ChrisAnnTerra/Solar-USB-Charger/README.md

## DIY Solar Battery Charger

Power Electronics Class project for ENGR 460. This project was intended for personal use of hobbyist level electronics. 

### Please Refer to the Wiki for further documentation, circuit description, testing notes, and state of the project.
