ChrisAnnTerra/Solar-USB-Charger/JessopIII_SPP460/JessopIII_SPP460.kicad_pcb

## KiCad design JessopIII_SPP460/JessopIII_SPP460.kicad_pcb (2020-06-02)

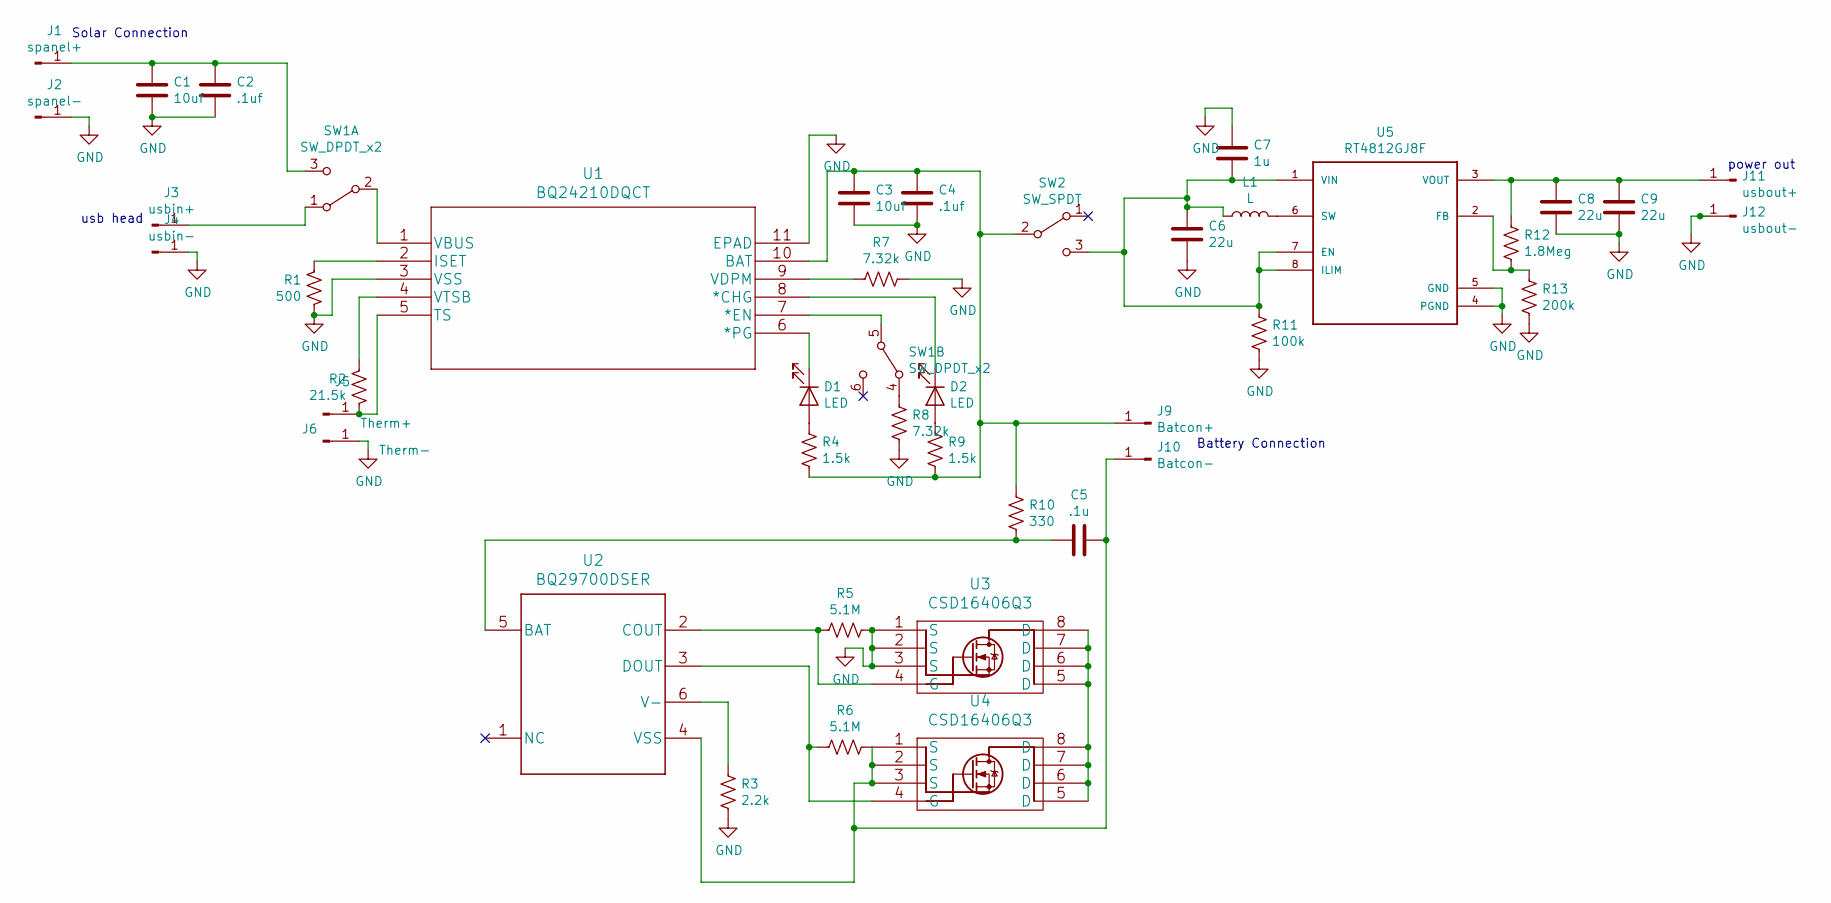
[picture p1: schematic JessopIII_SPP460.sch, Solar powered battery]

Parts:
C1, C3: 10uf; C_0805_2012Metric
C2, C4: .1uf; C_0805_2012Metric
C5: .1u; C_0805_2012Metric
C6, C8, C9: 22u; C_0805_2012Metric
C7: 1u; C_0805_2012Metric
D1, D2: LED; LED_0805_2012Metric
J1: spanel+; SolderWirePad_1x01_Drill1mm
J2: spanel-; SolderWirePad_1x01_Drill1mm
J3: usbin+; SolderWirePad_1x01_Drill1mm
J4: usbin-; SolderWirePad_1x01_Drill1mm
J5: Therm+; SolderWirePad_1x01_Drill1mm
J6: Therm-; SolderWirePad_1x01_Drill1mm
J9: Batcon+; SolderWirePad_1x01_Drill1.5mm
J10: Batcon-; SolderWirePad_1x01_Drill1.5mm
J11: usbout+; SolderWirePad_1x01_Drill1mm
J12: usbout-; SolderWirePad_1x01_Drill1mm
L1: L; L_Bourns-SRN6028
R1: 500; R_0805_2012Metric
R2: 21.5k; R_0805_2012Metric
R3: 2.2k; R_0805_2012Metric
R4, R9: 1.5k; R_0805_2012Metric
R5, R6: 5.1M; R_0805_2012Metric
R7, R8: 7.32k; R_0805_2012Metric
R10: 330; R_0805_2012Metric
R11: 100k; R_0805_2012Metric
R12: 1.8Meg; R_0805_2012Metric
R13: 200k; R_0805_2012Metric
SW1: SW_DPDT_x2; SW_CuK_JS202011CQN_DPDT_Straight
SW2: SW_SPDT; PinSocket_1x03_P2.54mm_Vertical
U1: BQ24210DQCT
U2: BQ29700DSER
U3, U4: CSD16406Q3; TRANS_CSD17575Q3
U5: RT4812GJ8F; SOT65P279X100-8N

Connections:
GND: C1.2, C2.2, C3.2, C4.2, C6.2, C7.1, C8.2, C9.2, J2.1, J4.1, J6.1, J12.1, R1.1, R3.2, R5.1, R7.1, R8.2, R11.2, R13.2, U1.3 (VSS), U1.11 (EPAD), U3.1 (S), U3.2 (S), U3.3 (S), U5.4 (PGND), U5.5 (GND)
unnamed: C1.1, C2.1, J1.1, SW1.3 (C)
unnamed: C3.1, C4.1, J9.1, R4.2, R9.2, R10.1, SW2.2 (B), U1.10 (BAT)
unnamed: C5.1, J10.1, R6.1, U2.4 (VSS), U4.1 (S), U4.2 (S), U4.3 (S)
unnamed: C5.2, R10.2, U2.5 (BAT)
unnamed: C6.1, C7.2, L1.1, R11.1, SW2.3 (C), U5.1 (VIN), U5.7 (EN), U5.8 (ILIM)
unnamed: C8.1, C9.1, J11.1, R12.1, U5.3 (VOUT)
unnamed: D1.1 (K), U1.6 (*PG)
unnamed: D1.2 (A), R4.1
unnamed: D2.1 (K), U1.8 (*CHG)
unnamed: D2.2 (A), R9.1
unnamed: J3.1, SW1.1 (A)
unnamed: J5.1, R2.1, U1.5 (TS)
unnamed: L1.2, U5.6 (SW)
unnamed: R1.2, U1.2 (ISET)
unnamed: R2.2, U1.4 (VTSB)
unnamed: R3.1, U2.6 (V-)
unnamed: R5.2, U2.2 (COUT), U3.4 (G)
unnamed: R6.2, U2.3 (DOUT), U4.4 (G)
unnamed: R7.2, U1.9 (VDPM)
unnamed: R8.1, SW1.4 (A)
unnamed: R12.2, R13.1, U5.2 (FB)
unnamed: SW1.2 (B), U1.1 (VBUS)
unnamed: SW1.5 (B), U1.7 (*EN)
unnamed: U3.5 (D), U3.6 (D), U3.7 (D), U3.8 (D), U4.5 (D), U4.6 (D), U4.7 (D), U4.8 (D)

Notes on the sheet:
usb head
Battery Connection
Solar Connection
power out

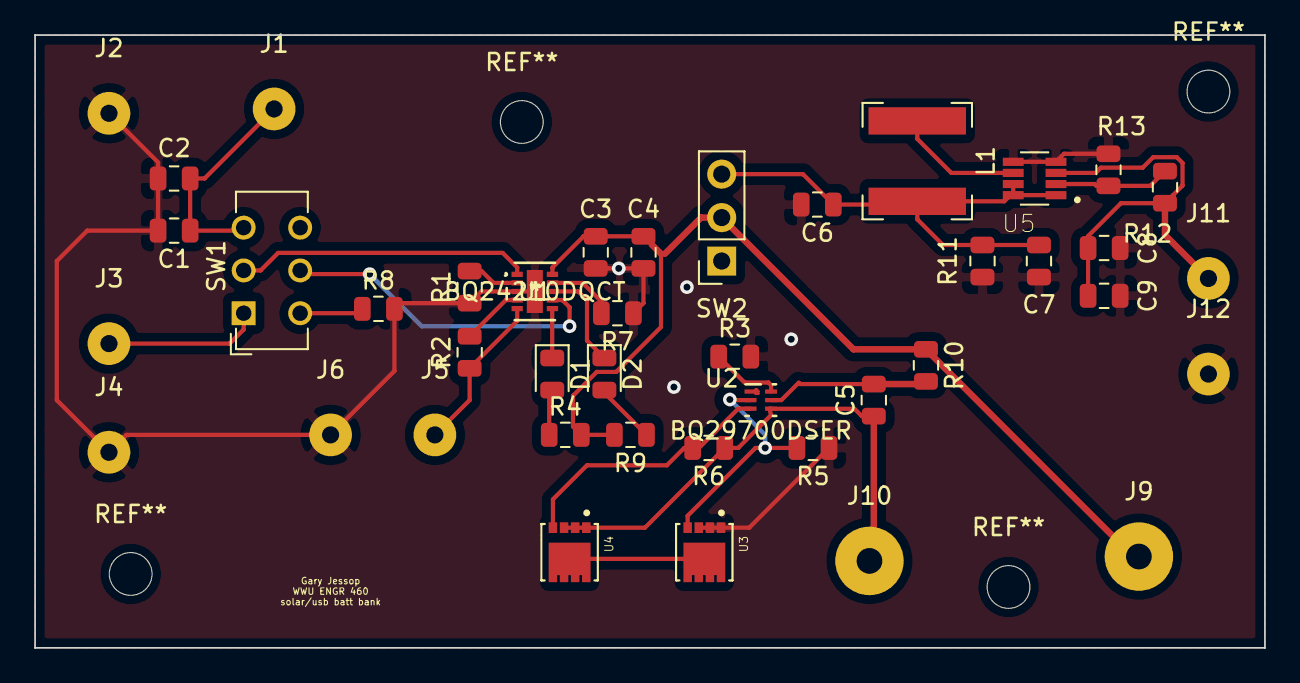
[picture p2: board JessopIII_SPP460.kicad_pcb from above]

Board: 2 copper layers, 71.9 x 35.8 mm, 42 parts (0 on the bottom side), 25 nets.
