ChrisAnnTerra/Solar-USB-Charger/(threads)

Thread 1 (2020-06-10):

Reversed IC

ChrisAnnTerra, 2020-06-10:
one of the ICs on the prototype is flipped.

Thread 2 (2020-06-11):

Reroute Pins

ChrisAnnTerra, 2020-06-11:
On the schematic, the BQ234210 IC needs to have pin 9 and pin 7 swapped. Pin 7 also needs to be tied to ground to achieve low state.
